aleung/KosselPrinter/RAMPS1.4/README.md

# RAMPS 1.4

官网：<https://reprap.org/wiki/RAMPS_1.4>

## 接线

电源输入

- 两组电源输入，编号分别为5A（12V）和11A（12V2）。用12V供电，过高电压会有问题。
- 其中11A仅仅用于给D8供电，通常用于热床。
- 其他接口均为通过5A接口输入来供电，包括通过二极管D1向Arduino Mega供电（VIN脚）
- 若Arduino希望通过USB独立供电，则需要断开D1
- 5A接口的输入靠二极管D2稳压到12V，因此输入电压不能高于12V太多
- 11A与5A接口内部电路独立。若不接热床，可以仅仅通过5A接电源输入。要使用D8则必须两个都接电源输入
- 实际测试在打印过程中耗电约50W（无热床，打印头200度），折算为5A接口输入电流约4～5A（所以标记为5A）。
- 在reset按钮旁边的3针接口为可选的PSU（例如ATX电源）连接

  - PS_ON pin: 控制电源的开关，若firmware支持，通过GCODE M80/M81控制。必须要靠5V供电

  - VCC pin：连接到Arduino的5V供电（VCC脚）。此脚可以接ATX电源的5V输出，给Arduino供电。当从此pin供电时，需要断开二极管D1。Arduino不允许同时从VCC和VIN供电。

  - 若要使用PS_ON来软件控制电源开关，应该使用5V供电以保持待机状态，因为电源会长期保持这个5V供电，不会因为PS_ON控制而关闭。

  - 5V pin：舵机（servos）的5V供电接口，可以接电源的5V供电，也可以用跳线与VCC针脚短接。当与VCC针脚短接时，就会使用Arduino的5V给舵机供电（Arduino需要接USB供电），而RAMPS无需接电。3D打印机通常用不上舵机接口，因此此针脚可以不接。

热床供电问题

- 11A接口的PTC自恢复保险F1的电压为16V，不能用24V供电
- 热床用12V供电时电流可达10A以上，要求电源至少能供给11A
- 热床供电（D8）的MOSFET非常热
- PCB的设计和制作问题，大电流容易出现过热烧坏
- 建议使用外接 MOSFET relay 模块对热床供电，D8仅作为控制信号
- 外接 MOSFET 热床供电时，必须要串接保险丝，以防短路！！
- 热床通常为100～120W，24V供电时在5A以内，选择8A保险管

D2旁边有个2 pin接口为12V-AUX，可以用于对外提供12V供电，例如RAMPS散热风扇（不可调速）

以下为Marlin固件的预设

D8/9/10输出

- +V端与电源+输入端连通，总有正电压；-V端通过MOSFET连接电源地，受程序控制导通
- 对于某个输出，可以断开+V端（悬空），直接通过独立的电源供电，这样可以选择不同于RAMPS供电电压，例如风扇或者热床采用非12V电压。不同电压的电源需要共地（需要注意电源是否允许这样接）。
- D10: 挤出头1加热
- D9: 挤出头2加热，或者工件散热风扇（调速）
- D8：热床

温度传感器接头

- T0：挤出头1
- T1：热床
- T2：挤出头2
