aleung/KosselPrinter/model/bed_shape/2020/bed_shape.png

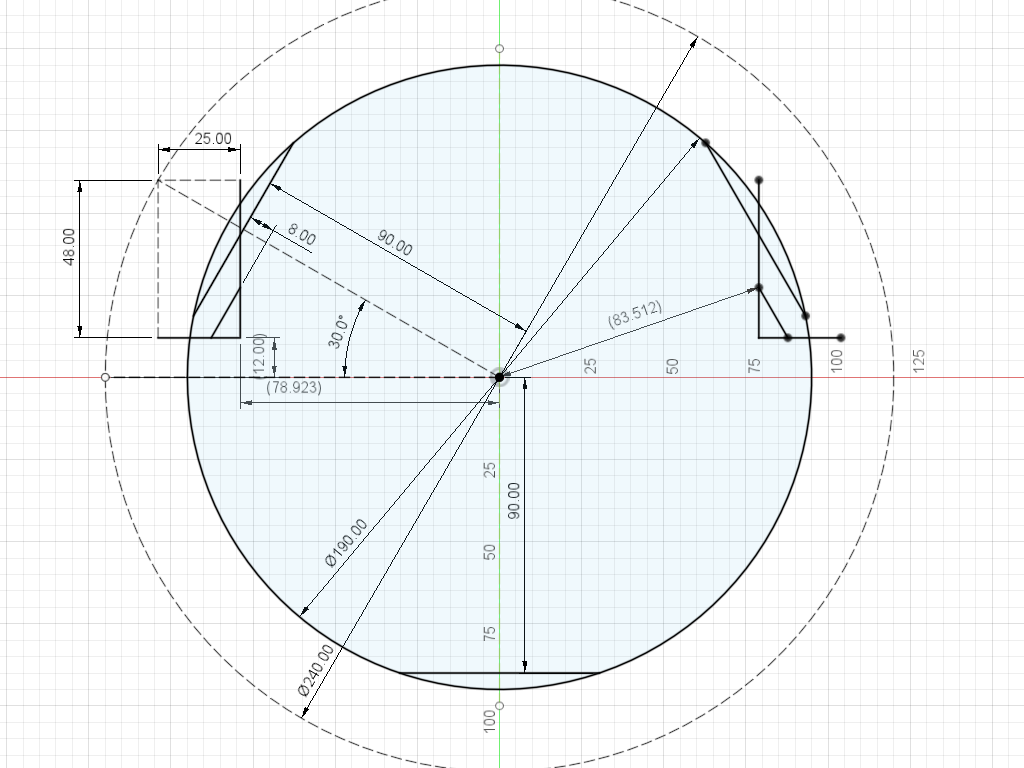
model/bed_shape/2020/bed_shape.png
