aleung/KosselPrinter/model/bed_shape/2020/texture.png

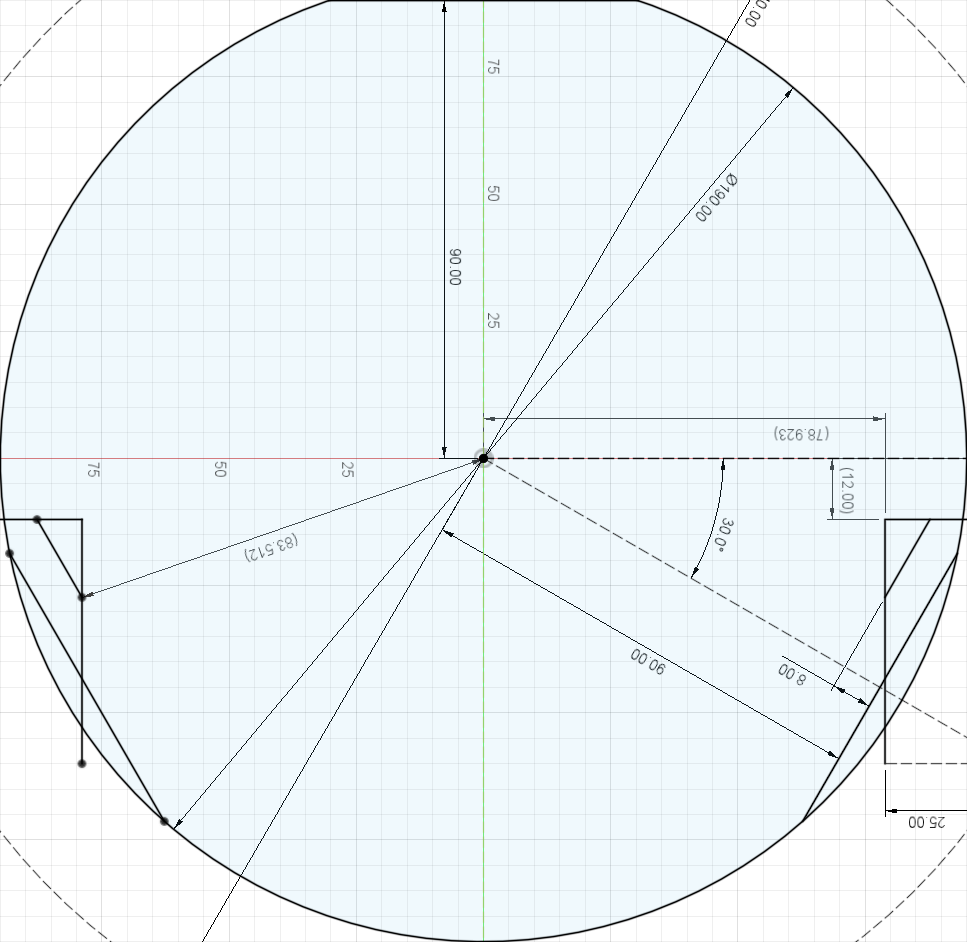
model/bed_shape/2020/texture.png
