aleung/KosselPrinter/model/bed_shape/2021/bed_shape.png

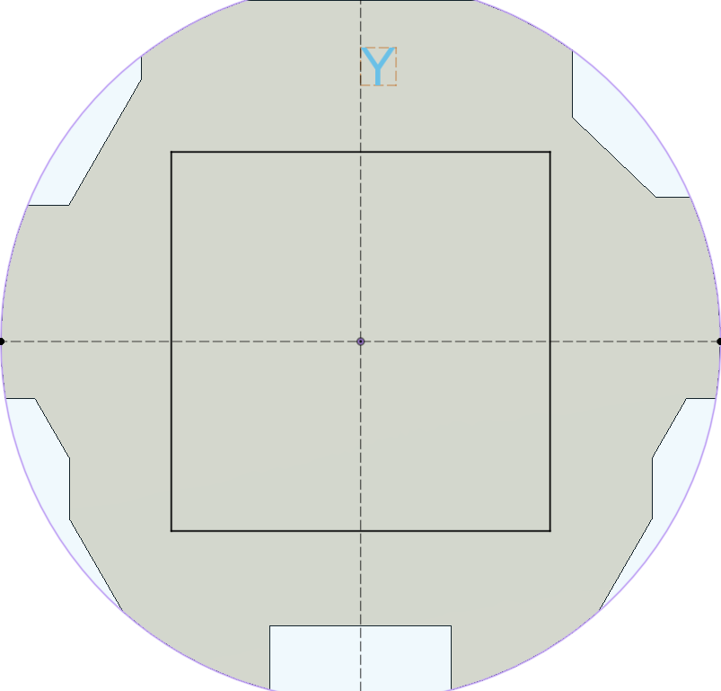
model/bed_shape/2021/bed_shape.png
