aleung/KosselPrinter/RAMPS1.4/RAMPS-connect.jpg

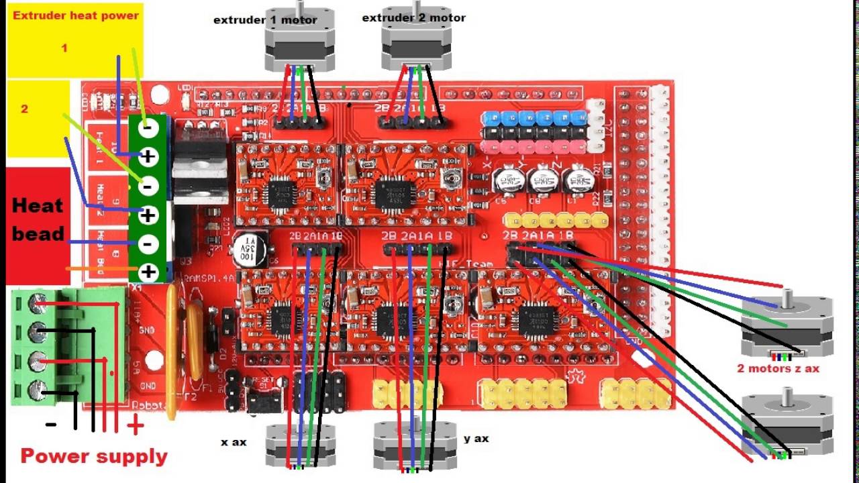
RAMPS1.4/RAMPS-connect.jpg
