aleung/KosselPrinter/RAMPS1.4/real.jpg

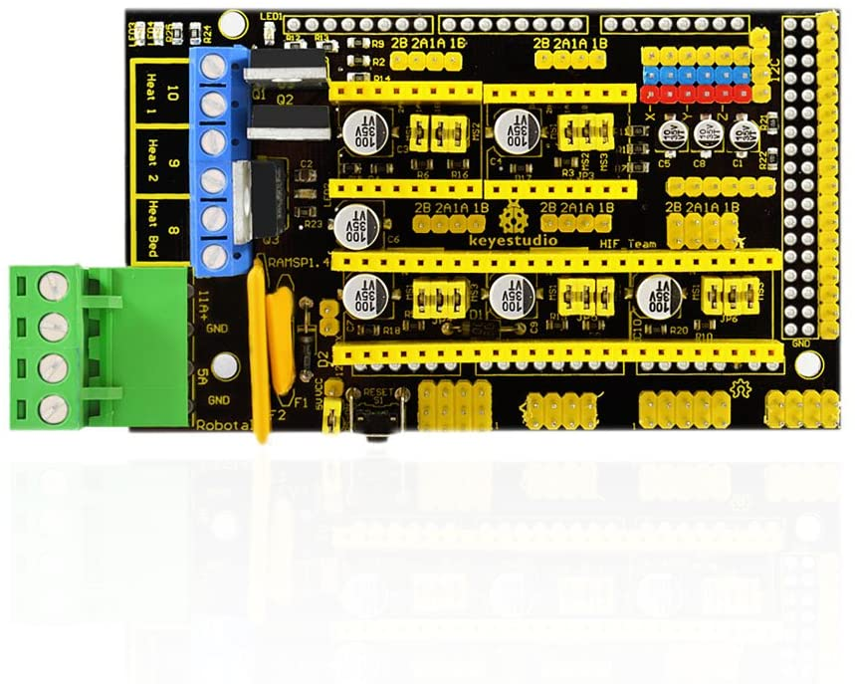
RAMPS1.4/real.jpg
