aleung/KosselPrinter/BOM.xlsx

Item | Type | Quantity | Unit Price | Amount | Taobao ItemID | Seller | Comment | Ordered | Date
框架水平杆 | 240mm, 欧标2020铝材 | 9
框架竖杆 | 650mm, 欧标2020铝材 | 3
 | 共约4米 |  | 12 | 50 | 36456442504 | 广东华通铝业 | 欧标 | received | 2015-10
框架连接件 | 铝 | 1 set |  | 160 | 43119800256 | kossel铝合金件 | 可用欧标铝型材，但竖杆固定只能用国标方螺母 | received | 2015-10
M3欧标 T 型滑块 |  | 50 | 0.23 | 11.5 | 41970628579 | 华达五金店 | 框架，应该用 M4代替 | received | 2015-10
M3欧标 T 型螺母 | 20-TM3 | 100 | 0.45 | 45 | 16474621166 | 广东华通铝业
 |  | 100 | 0.18 | 18 | 41911582347 | 华达五金店 |  | received | 2015-10
M3垫圈 |  | 100 |  | 2.2 | 40089954194 | creaby旗舰店 | 不需要这么多 | received | 2015-10
M3*6mm 内六角螺丝 |  | 50 |  | 2.39 | 40151436582 | creaby旗舰店 | 基本上用不着，都用 M3*8 | received | 2015-10
M3*8mm 内六角螺丝 |  | 100 |  | 4.78 | 40151436582 | creaby旗舰店 | 框架及大部分元件安装，框架应该用 M4代替 | received | 2015-10
M3*10mm 内六角螺丝 |  |  |  |  |  |  | 一部分地方M3*8不够长，需要10
M3*14mm内六角螺丝
M3*20mm内六角螺丝 |  | 6 | 0.09 | 0.54 | 44753078109 | creaby旗舰店 | 滑车 | received | 2015-10
M3*25mm 内六角螺丝 |  | 12 | 0.11 | 1.32 | 44753078109 | creaby旗舰店 | 法兰轴承，效应器挂杆 | received | 2015-10
M3*35mm 内六角螺丝 |  | 6 | 0.15 | 0.9 | 44753078109 | creaby旗舰店 | 皮带张紧 | received | 2015-10
M3尼龙防松自锁螺母 |  | 12 | 0.08 | 0.96 | 40003646337 | creaby旗舰店 |  | received | 2015-10
M2.5*12mm内六角螺丝 |  | 6 | 0.06 | 0.36 | 40150872890 | creaby旗舰店 | 微动开关 | received | 2015-10
M2.5*16mm内六角螺丝 |  | 3 | 0.07 | 0.21 | 40150872890 | creaby旗舰店 | 水平探测 | received | 2015-10
M4*10mm内六角螺丝 |  | 50 |  |  |  |  | 框架 | received | 2015-10
M4国标方螺母 |  | 50 |  |  |  |  | 框架 | received | 2015-10
MGN12H 直线滑轨 | 450mm | 3 | 150 | 450 | 42974167954 | 锐力斯传动总店 | 500mm
 |  | 1 set |  | 648 | 14821319932 | 上海恩瑞特传动科技 | 上银
 |  |  |  | 279 | 13271784463 | 上海顺祥传动轴承 | 国产 500mm
 |  |  |  | 279 | 26759568854 | 上海勤慎机电 | 国产，质量差，退货 | returned
 |  | 1set |  | 407 | 38226154679 | 精嘉 | 仿HIWIN，实际国产 | received | 2015-10
2GT-6 同步带 | 6mm宽，2mm齿距，长1280mm，3根 (共约4m) |  | 6.5/m | 25 | 36528715418 | 小齿距同步带同步带轮 | 要买好点的？
 |  |  | 14.1/m | 56 | 37292680594 | 锐力斯传动总店 | UNITTA | received | 2015-10
GT2同步轮 | 齿宽7mm，齿距2mm，5mm孔径，齿数16齿 | 3 | 7 | 21 | 36316218657 | 小齿距同步带同步带轮
 |  | 3 | 8.5 | 25.5 | 44752555536 | 锐力斯传动总店 | 16-2GT-6-P5 | received | 2015-10
法兰轴承 | F623zz | 6 | 2.5 | 15 | 38330349569 | 瓦通五金专营店
 |  | 6 | 1.5 | 9 | 43459032197 | kossel铝合金件 |  | received | 2015-10
步进电机 | 42步进（NEMA17），机身长度47mm，5mm 直径 D 型轴 , 1.8度 | 3 | 45 | 135 | 3949282634 | 乐清宇辉精密电机 | 42BYGH47-401A, 0.55Nm，1.5A；加装杜邦4pin端子 有一个容易失步，需要更换 | received | 2015-10
 |  | 1 | 32.5 | 32.5 | 42769125555 | 嘉利保点子 | 42BYGH47-1704A, 0.55Nm, 1.7A |  | 2018-1
送料步进电机 | 42步进（NEMA17），机身长度60mm，D 轴 | 1 | 65 | 65 | 4094495224 | 乐清宇辉精密电机 | 42BYGH60-401A, 0.7Nm，1.5A；加装杜邦4pin端子 | received | 2015-10
远程挤出机 | MK8, 铝 | 1 set |  | 45 | 45550954200 | 普林特电子 | 扳机型，已配接头 | received | 2015-10
 | 铝 | 1 set |  | 88 | 521771801250 |  | 马蹄型，无接头、送丝轮？
挤出头 | 0.4mm直径挤出嘴+加热铝块+12V40W加热棒+100k热敏电阻+铝散热片/喉管+直插接头，1.75mm远程挤出 |  |  |  |  |  | PC4-01直插接头
 |  |  |  | 75 | 44518399646 | 人人三维 | E3D v6+2.0,配送0.8米远程送料管
 |  |  |  | 48 | 43794905334 | 人人三维 | E3D v6+
 |  |  |  | 27.7 | 42759070743 | 普林特电子 | E3D v6 | received | 2015-10
喉管 | E3D v6, 1.75mm 内置铁氟龙管 | 2 | 1.07 | 2.14 |  | 启庞3D | 不容易堵头 | received | 2018-1
 | E3D v6, 4.1内孔直通 | 1 | 0.5 | 0.5 |  | 启庞3D |  | received | 2018-1
快接头 | E3D v6 ，直通，M4管径 | 3 | 0.77 | 2.31 |  | 启庞3D |  | received | 2018-1
喷嘴 | E3D v6, 1.75mm耗材，0.4mm | 2 | 0.65 | 1.3 |  | 启庞3D |  | received | 2018-1
打印头风扇 |  | 1 |  | 6.8 | 43279615296 | 普林特电子 | v6风扇罩 | received | 2015-10
微型钻头 | 0.4mm |  |  | 2 | 40274533254 | 普林特电子 | 疏通挤出头 | received | 2015-10
四氟管 | 内径2mm外径4mm，65cm |  | 2.1 |  | 21657103024 |  | 透明
 |  |  | 1.8 |  | 527848098168 | 启庞3D | 乳白色 | received | 2018-1
 |  |  | 3 |  | 43015114835 | 普林特电子 | 透明 | received | 2015-10
斜杆 | 碳管+球头/鱼眼 |  |  |  |  |  |  | NA
 |  |  |  | 70 | 520632284040 | 学生党3DIY创意馆 | M3鱼眼+5*3碳杆，已粘好
 |  |  |  | 75 | 42759507561 | MICROMAKE | M3鱼眼+5*3碳杆，已粘好
斜杆套件 | 斜杆+效应器+斜杆滑车连接件+螺丝 |  |  | 199 | 45475115936 | 人人三维 | 注塑件，鱼眼 | received | 2015-10
 |  |  |  | 160 | 43800881158 | 子浩科技 | PLA打印机，M3鱼眼，3010散热风扇+5012鼓风
效应器 | 铝
同步带张紧弹簧 |  | 3 | 0.09 | 0.27 |  | 启庞3D |  | received | 2018-1
斜杆减震弹簧 |  | 3 | 0.19 | 0.57 |  | 启庞3D |  | received | 2018-1
底盘 | 高硼硅玻璃，直径200mm，厚3mm |  | 1 | 25 | 39147972804 | 秦皇岛利东特种玻璃
 |  |  |  | 28 | 44631332459 | 人人三维
 |  |  |  | 20 | 521224739716 | 普林特电子 |  | received | 2015-10
热床电源 | 24V |  |  | 35 |  |  | 明纬 NES-350-24 |  | 2021-1
热床MOS模块 |  |  |  | 8.99 |  |  |  |  | 2021-1
热床 |  |  |  | 30 |  |  | 直径220，厚度3mm，铝基板，PCB |  | 2021-1
非标件套装 | 滑块推杆座+效应器+限位开关底座+挤出机+自动调平感应座 |  |  | 50 | 45052661238 | 学生党3DIY创意馆 | 打印件 | NA
压力传感器 | 调平用，套在喷嘴上 |  |  | 19.8 | 547224018549 | 小柴人3D | 配 E3D v6 喷嘴 | received | 2018-1
光电限位开关 |  | 4 | 3.9 | 15.6 | 550314940030 | 小柴人3D | 只需3个 | received | 2018-1
微动开关 | 欧姆龙SS-5 | 4 | 1.91 | 7.64 | 8984572298 | 上海仁玺电子 | 印尼产 SS-5GL
 |  | 4 | 1.9 | 7.6 | 36299264965 | 品牌继电器 | 印尼产 SS-5GL
 |  | 4 | 3 | 12 | 45755819186 | 人人三维 | 印尼产 SS-5GL | received | 2015-10
限位开关底座 |  | 3 | 2 | 6 | 524303187130 | 劲云三维 |  | received | 2017-12
Power | 12V >5A |  |  | 29 | 45859425007 | 腾锋线材 | 台达，10A | received | 2015-10
Arduino | MEGA2560 R3 | 1 | ~40 |  |  |  |  | NA
LCD模块 | Reprap2004 | 1 |  | 28 | 38267240503 |  |  | NA
RAMPS1.4 |  | 1 | 20~27 | 25 | 522117368072 | 人人三维 |  | NA
步进电机驱动 | 2A电流的绿色4988驱动 | 4 | 6.7 | 26.8 | 37933530722 |  | 附送散热片及双面硅胶 | NA
 | TMC2225 | 3 | 11.07 | 33.21 |  | 启庞3D |  |  | 2022-6
 | 乐积TMC2225 | 1 | 12.8 | 12.8 |  | 乐积科技 |  |  | 2023-2
控制电路套件 |  | 1 set
 |  |  |  | 130 | 40241939700 | 普林特电子 | MEGA2560+RAMPS+2004LCD+4988*5+散热片 REPRAP_DISCOUNT_SMART_CONTROLLER | received | 2015-10
 |  |  |  | 102 | 40273837410 | 普林特电子 | MEGA2560+RAMPS+4988*5+散热片
电路板散热风扇 |  | 1 |  |  |  |  |  | received | 2015-10
打印耗材 | 1.75mm 直径，PLA, 1kg | 2 | 66 | 132 | 19695022005 | Kexcelled 3D打印耗材 |  | received | 2015-10
 | 1.75mm 直径，PLA, 500g | 1 | 25 | 25 | 556517045680 | 启庞3D | 白色 | received | 2018-1
游标卡尺 |  |  |  | 93 |  | 华诚五金 | 广陆150mm，0.02mm | received | 2015-10
PVP固体胶 |  |  |  |  |  |  | PVP材质固体胶可以代替美纹纸，牌子不限 | received
螺纹胶 | 242型，颜色蓝色，温度范围-50~150℃，固化时间20min/24h(初固/全固)
扎带 | 3*80mm, 1000条 |  |  | 10 | 18876170071 | 腾锋线材 | 有些地方长度不够 | received | 2015-10
扎带 | 12cm
润滑黄油
电线缠绕管 | 8mm，10m |  |  | 6 |  | 普林特电子 |  | received | 2015-10
热缩管 | 1, 2, 4mm 各半米 |  |  | 2 | 43199296385 | 人人三维 | 1mm太细，没有用 | received | 2015-10
杜邦线 | 70cm 2pin 母－母 | 5 | 0.6 | 3 | 37169898528 | 普林特电子 |  | received | 2015-10
导热胶
铲子
密封盒 | 8.5L，KL－2020，27*20*23cm |  |  | 24.3 | 3095680751 | 莎莎日用生活馆 | 装耗材 | received | 2018-1
变色硅胶干燥剂（橙色） | 500g |  |  | 15.8 | 39042466599 | 禾壹诚品 | 耗材吸湿 | received | 2018-1
