aleung/KosselPrinter/parts/effector.jpg

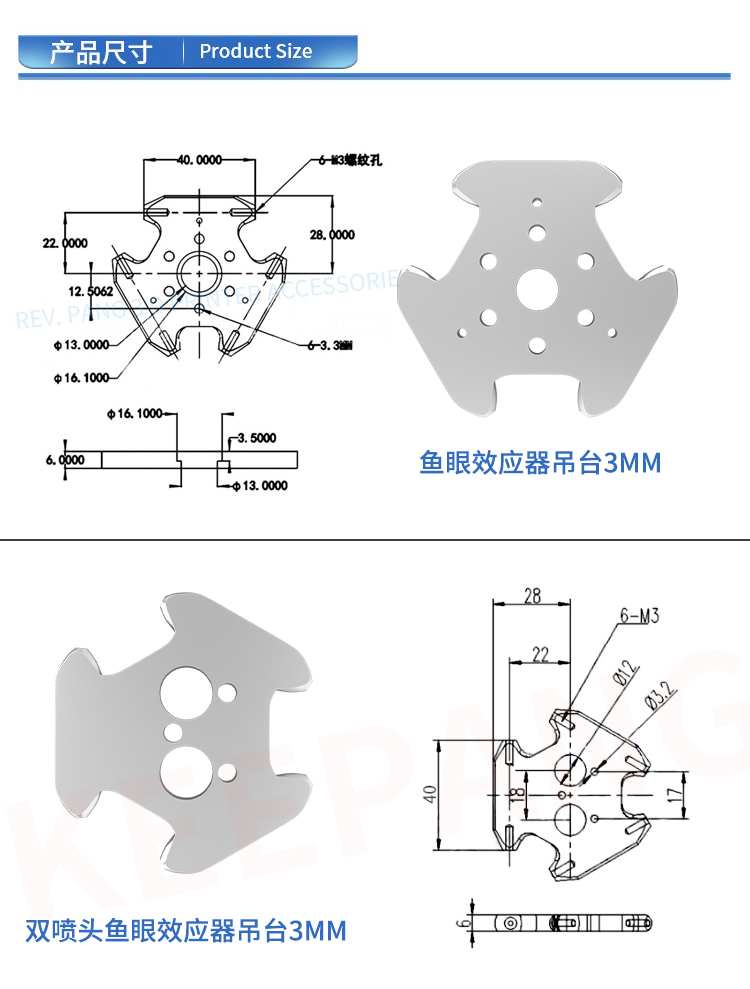
parts/effector.jpg
