aleung/KosselPrinter/parts/heat-bed.png

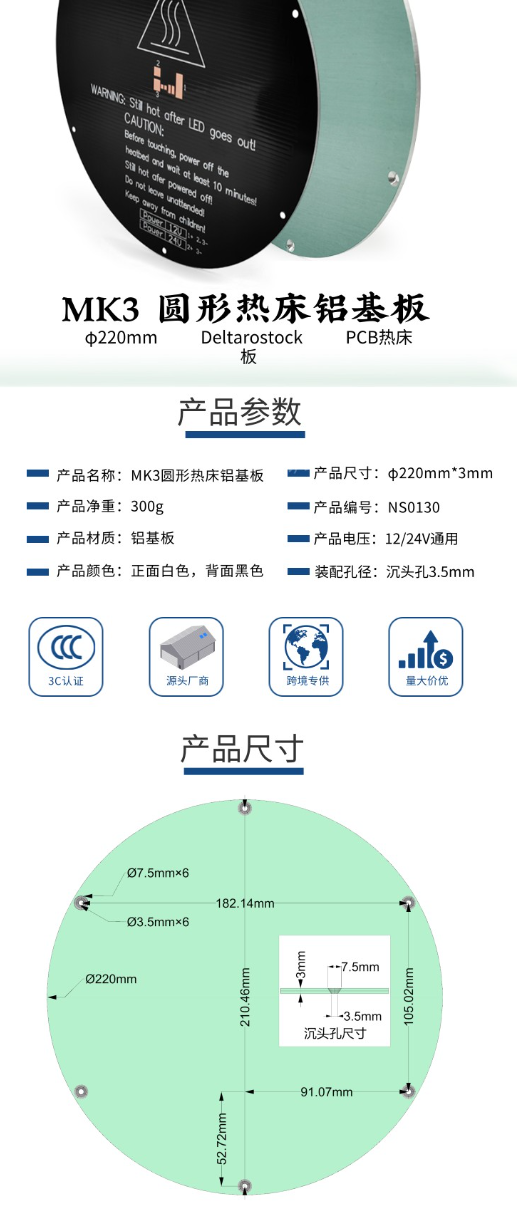
parts/heat-bed.png
