aleung/KosselPrinter/parts/hotbed-power-control.png

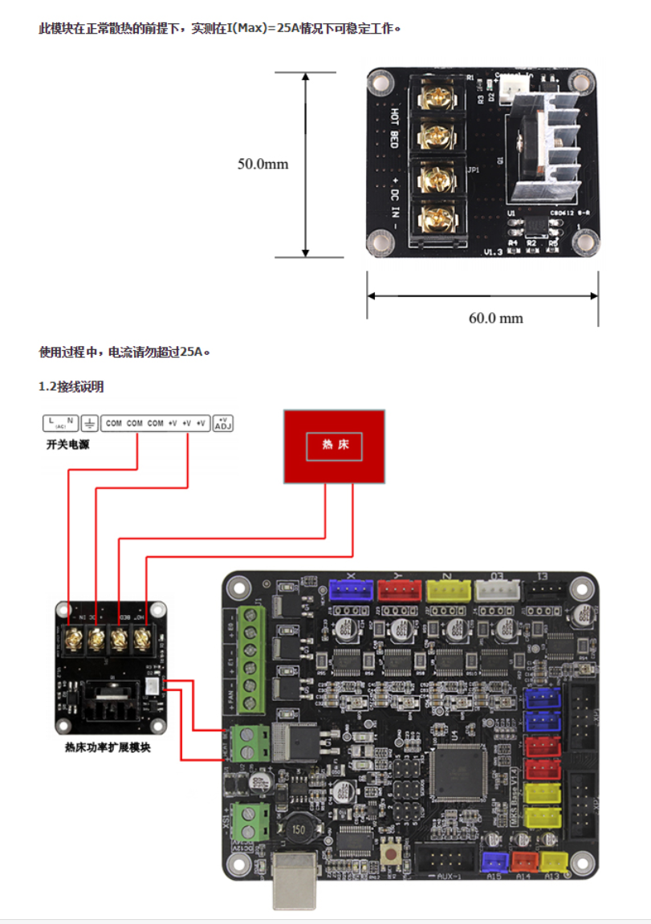
parts/hotbed-power-control.png
