aleung/KosselPrinter/parts/TMC2225-1.png

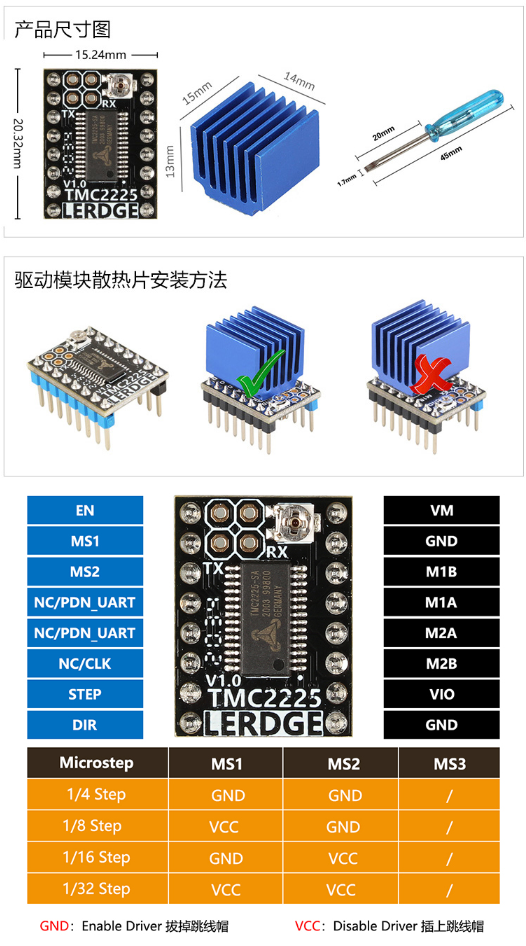
parts/TMC2225-1.png
