aleung/KosselPrinter/parts/TMC2225-2.png

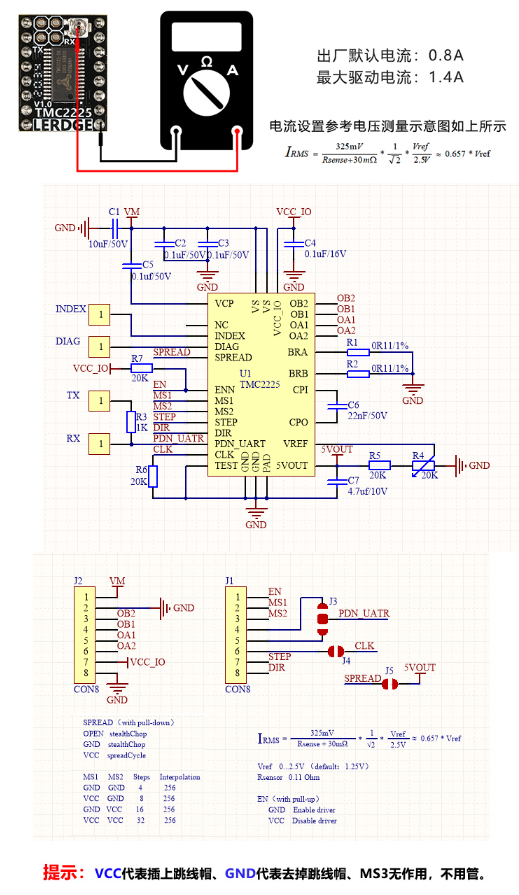
parts/TMC2225-2.png
