aleung/KosselPrinter/model/bed_shape/2020/bed_shape.stl

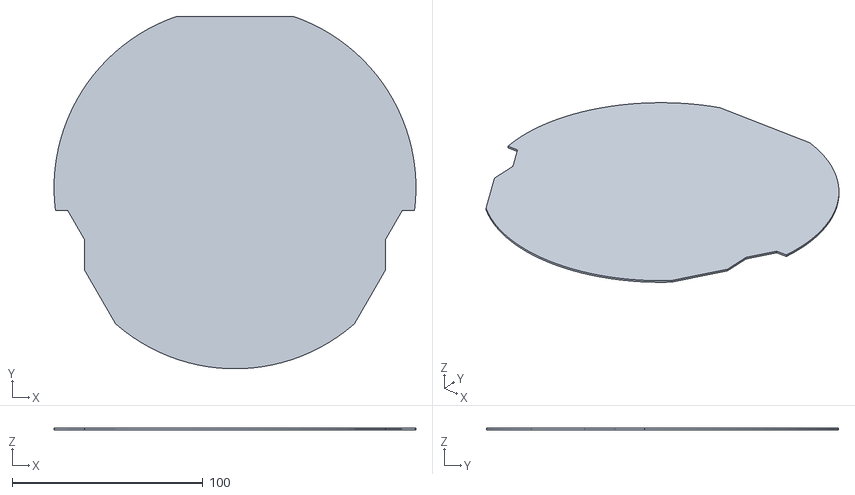
[picture p14: CAD file, 2020-04-05]
model/bed_shape/2020/bed_shape.stl
190.0 x 185.0 x 1.00
