aleung/KosselPrinter/model/calibration/klipper_delta_calibrate_size.3mf

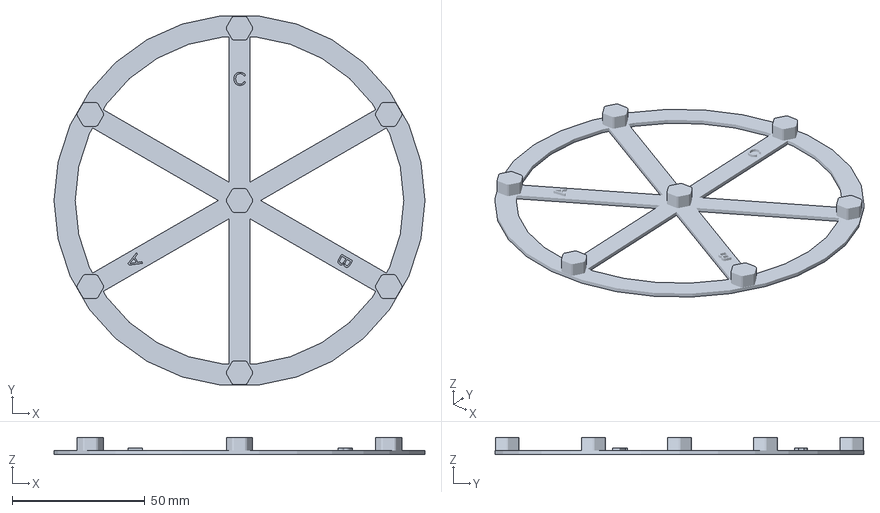
[picture p15: CAD file, 2023-03-03]
model/calibration/klipper_delta_calibrate_size.3mf
140.0 x 139.2 x 6.50 mm
