aleung/KosselPrinter/model/calibration/ExtrusionMultiplier.3mf

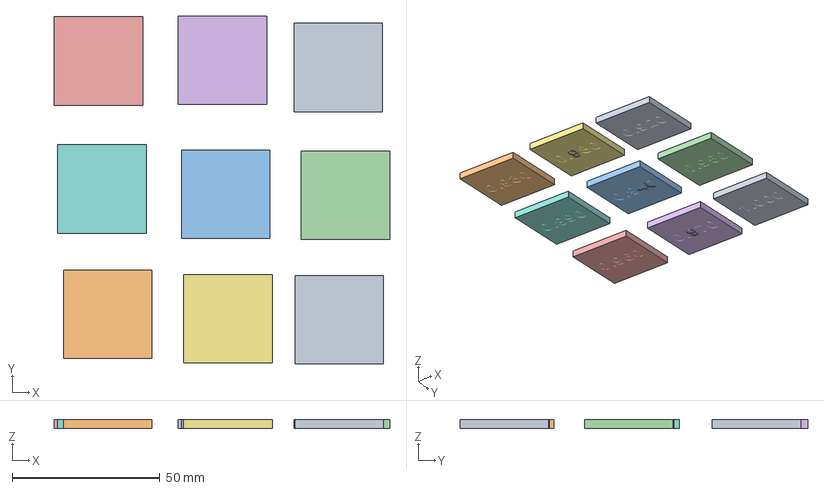
[picture p16: CAD file, 2023-02-26]
model/calibration/ExtrusionMultiplier.3mf
113.5 x 117.6 x 3.00 mm
EM_Cube-0.920.stl
EM_Cube-0.930.stl
EM_Cube-0.940.stl
EM_Cube-0.950.stl
EM_Cube-0.960.stl
EM_Cube-0.970.stl
EM_Cube-0.980.stl
EM_Cube-0.990.stl
EM_Cube-1.000.stl
