aleung/KosselPrinter/model/calibration/simple-crossing.stl

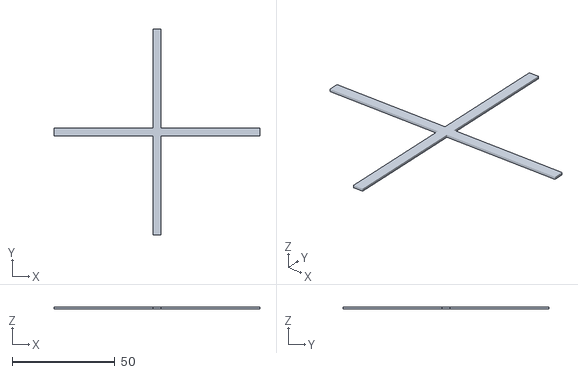
[picture p17: CAD file, 2021-02-12]
model/calibration/simple-crossing.stl
100.0 x 100.0 x 1.00
