aleung/KosselPrinter/model/calibration/xy100mm.stl

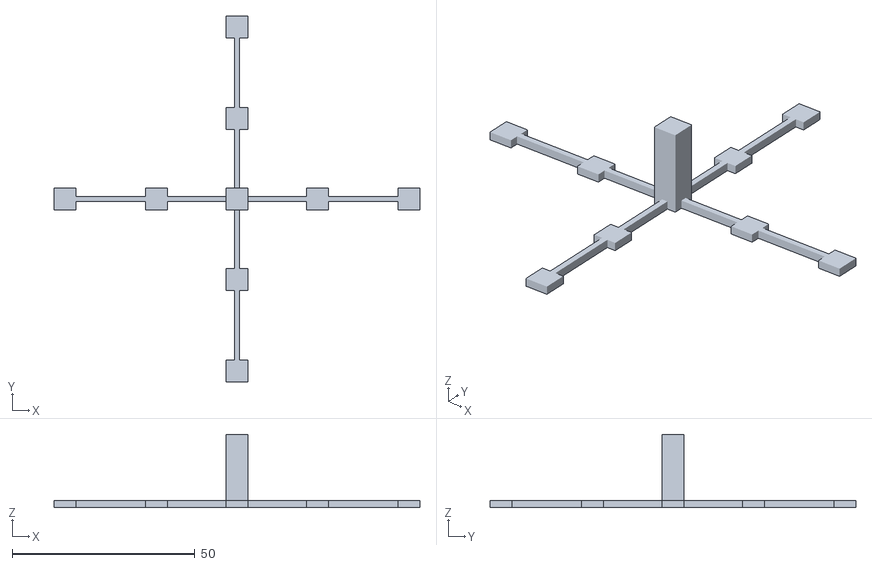
[picture p18: CAD file, 2021-02-12]
model/calibration/xy100mm.stl
100.0 x 100.0 x 20.0
