aleung/KosselPrinter/model/calibration/Overhang_Angle_Test_55-85.stl

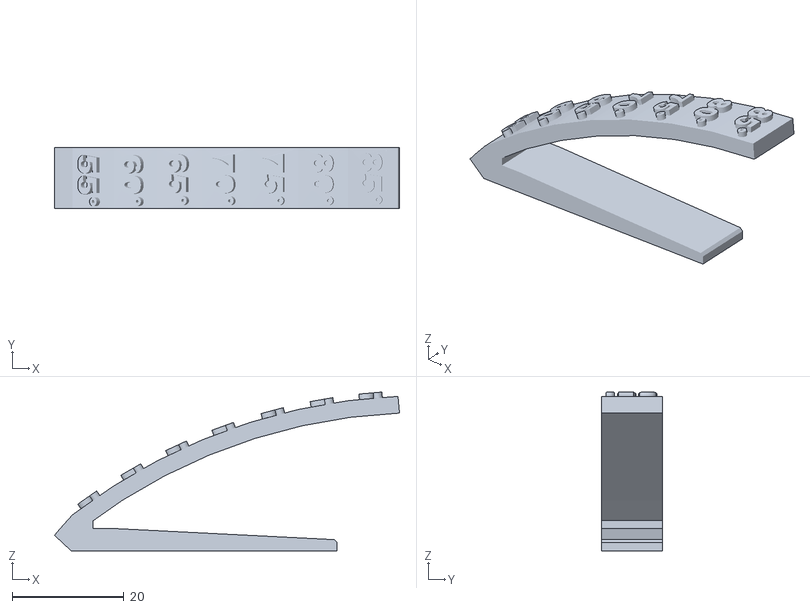
[picture p19: CAD file, 2020-03-05]
model/calibration/Overhang_Angle_Test_55-85.stl
61.8 x 11.0 x 28.4
