aleung/KosselPrinter/model/calibration/bridge.stl

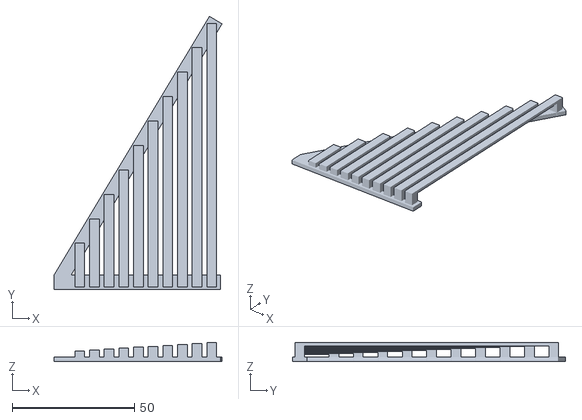
[picture p20: CAD file, 2020-03-05]
model/calibration/bridge.stl
68.8 x 111.8 x 7.90
