aleung/KosselPrinter/model/calibration/xyzCalibration_cube.stl

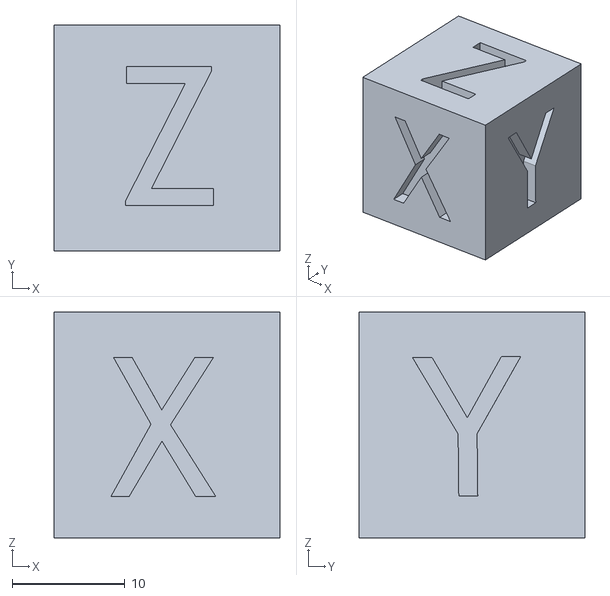
[picture p21: CAD file, 2018-02-03]
model/calibration/xyzCalibration_cube.stl
20.0 x 20.0 x 20.0
