aleung/KosselPrinter/(list of files, cad)

Other CAD files:
model/bed_shape/2021/bed_shape.stl
making/plumb_bob/polyScrewThread_r1.scad
model/bed_shape/2020/bed_shape.f3d
model/bed_shape/2021/bed_shape.f3d
model/calibration/klipper_delta_calibrate_size.stl
model/calibration/xy100mm.f3d
