aleung/KosselPrinter/(commit log)

2015-09-28 所有元件基本上已经选定买齐
    [BOM.xlsx]
2015-10-13 滑轨下单
    [BOM.xlsx]
2016-02-28 全部零件齐备
    [BOM.xlsx]
2017-12-25 加电测试完成，补充资料
    [BOM.xlsx]
2018-02-03 Add models
    [BOM.xlsx, e3d_v6_2in1_duct.scad, e3d_v6_2in1_duct.stl, endstop.scad, light-blocker.scad, xyzCalibration_cube.stl]
2018-02-03 Update E3D 2in1 duct after first print
    [e3d_v6_2in1_duct.scad, e3d_v6_2in1_duct.stl]
2018-02-05 Change fan tilt to 30 degree
    [e3d_v6_2in1_duct.scad, e3d_v6_2in1_duct.stl]
2018-02-06 Minor adjustment after printout, fix too thin hotted duct
    [e3d_v6_2in1_duct.scad, e3d_v6_2in1_duct.stl]
2018-02-22 Finish LCD Box design
    [lcd_box.scad, lcd_box_bottom.stl, lcd_box_support.stl, lcd_box_top.stl, pinwheel_stand.scad]
2018-02-25 整理模型文件
    [e3d_v6_2in1_duct.scad, e3d_v6_2in1_duct.stl, endstop.scad, lcd_box.scad, lcd_box_bottom.stl, lcd_box_support.stl, lcd_box_top.stl, light-blocker.scad]
2018-03-10 Add new models
    [output.stl]
2018-03-21 Add new model
    [main.stl]
2018-06-03 Add makings
    [customizable_U_hook.scad, customizable_sanding_stick.scad, index.stl, pinwheel_stand.scad, polyScrewThread_r1.scad]
2018-07-14 making: bike rear light mount
    [back.stl, bike-rear-light-mount.scad, front.stl]
2018-07-22 Add making: torch diffuser, bike beam cutoff
    [beam-cutoff.scad, beam-cutoff.stl, torch_diffuser.scad, torch_diffuser.stl]
2018-07-25 将反光板做成弧形，扩大光斑范围
    [beam-cutoff.scad]
2018-07-25 基于v2的平面反光板版本作为v3基础
    [beam-cutoff.scad]
2018-07-25 平面反射面上增加棱柱，扩大反光范围
    [beam-cutoff.scad]
2018-07-25 改反光面为部分圆柱
    [beam-cutoff.scad, beam-cutoff.stl]
2018-07-27 减少反光板倾角，照亮更远处
    [beam-cutoff.scad]
2018-09-11 New modules
    [body.scad, configure.scad, index.scad, rotor.scad, tab.scad]
2018-09-12 update path to relativity.scad library
    [body.scad, index.scad, rotor.scad, tab.scad]
2018-09-16 soap holder
    [index.scad, index.stl]
2019-01-04 Filament hanger
    [assembled.scad, parts.scad]
2019-01-06 Final make of 喇叭转接环
    [index.scad, index.stl]
2019-01-07 Bottle coupler
    [PETcap.scad, bottle-coupler.stl, coupler.scad]
2019-01-16 牙膏牙刷挂架
    [toothbrush-holder.scad, toothbrush-holder.stl, toothpaste-wall-holder.scad, toothpaste-wall-holder.stl]
2019-01-21 Display controller board cover
    [index.scad, index.stl]
2019-01-21 New making
    [cap-holder.scad, cap-holder.stl, index.scad, index.stl, toothbrush-holder.scad, toothbrush-holder.stl]
2019-02-05 完成牙膏牙刷挂架
    [cap-holder.scad, cap-holder.stl, cup-holder.scad, cup-holder.stl, toothpaste-wall-holder.scad, toothpaste-wall-holder.stl]
2019-02-05 滑车挡板
    [index.scad]
2019-02-06 add STL files
    [pinwheel_stand.scad, pinwheel_stand_39x2.stl, pinwheel_stand_39x3.stl]
2019-02-12 Fix IKEA JÄLL laundry bag belt breakage
    [index.scad, index.stl]
2019-02-14 延长横杆，长于丝卷宽度
    [parts.scad]
2019-02-14 large version soap holder
    [large.scad, large.stl]
2019-02-27 角阀水管盖子
    [index.scad, index.stl]
2019-02-27 Update glass bed clamp v2
    [v1.stl, v2.scad, v2.stl]
2019-03-04 Hole cover
    [index.scad, index.stl]
2019-03-06 角阀墙孔盖
    [ring.scad, ring_d24.stl]
2019-03-10 rope cleat
    [index.scad, normal-body.stl, normal-covers.stl, small-body.stl, small-covers.stl]
2019-03-15 RAMPS case v2
    [v2-bottom.stl, v2-top.stl, v2.scad]
2019-03-23 牙刷头挂架加卡沿
    [toothbrush-holder.scad, toothbrush-holder.stl]
2019-04-12 Add and update things
    [assembled.scad, bar_bearing.stl, bracket.stl, index.scad, index.stl, led-power-box.scad, parts.scad, plate-only.scad]
2019-04-13 Update designs
    [bracket-v2.scad, bracket.scad, led-power-box.scad, nut.stl, power-box-plate-only.scad]
2019-05-11 New models
    [2.scad, part1.scad, part2.scad, part2.stl]
2019-05-31 提高紧固度
    [v2.scad]
2019-07-14 MBP 散热底座
    [down.scad, down.stl, upleft.stl, upmid.scad, upmid.stl, upright.scad, upright.stl]
2019-11-23 New makings
    [A.stl, B.stl, a.stl, b.stl, bar.stl, c.stl, cover.scad, cover.stl]
2019-12-15 Update filament holder design
    [assembled.scad, bar.stl, horizontal_bar.scad, parts.scad, topfix.stl, uphold.stl]
2019-12-19 New and update
    [body.stl, clip.stl, cover.stl, index.scad, index.stl, standard.scad, standard.stl]
2019-12-22 minor update
    [index.scad, index.stl]
2019-12-22 支持更宽的丝盘
    [bar_bearing.stl, parts.scad]
2020-01-06 Printer and slicer configuration backup
2020-01-11 E3d v6 风扇座 v2020.01
    [2018_02.scad, 2020_01.scad, 2020_01.stl]
2020-01-17 bed shape for setting in slicer
    [bed_shape.stl, index.scad]
2020-01-25 迪卡侬风车座v2
    [v1.scad, v2.f3d, v2.stl]
2020-02-04 New designs
    [adapter.stl, bottom.stl, component1.stl, design.f3d, gasket.stl, guide.3mf, guide.stl, top.stl]
2020-02-14 New and update models
    [72mm-OnePlus3.f3d, design.f3d, mobile_mount.stl, round.stl, 台灯臂连接件.f3d, 台灯臂连接件.scad]
2020-02-14 Calibration printing
    [Retraction.stl]
2020-02-16 Update design
    [toothbrush-holder-v2.stl, toothbrush-holder.scad]
2020-02-18 Fix: with small diameters (eg 4 mm), the sawdust channel in the drill guide is not properly created.
    [drillguide.scad]
2020-02-18 Support fluid ounce unit
    [conical_measure.scad]
2020-02-20 new design
    [wire-sleeve-d6x20.stl, wire-sleeve.scad]
2020-03-05 New and updated models
    [2018_02.scad, 2020_01.scad, 2020_01.stl, 2020_02_a.f3d, 2020_02_a.stl, 2020_02_b.f3d, 2020_02_b.stl, 2020_02_b2-gasket.stl]
2020-03-05 Printer calibration models
    [20x20x10-cube.stl, Overhang_Angle_Test_55-85.stl, bridge.stl]
2020-03-29 Move 3d models to new repo 3d-model
    [12cm_v1_1.stl, 12cm_v2.stl, 2.scad, 2018_02.scad, 2020_01.scad, 2020_01.stl, 2020_02_a.f3d, 2020_02_a.stl]
2020-04-05 New and calibrated bed shape
    [bed_shape.f3d, bed_shape.stl, index.scad]
2020-04-05 Update calibration setting
2020-05-05 Titan extruder
2021-02-12 Upgrade for PETG: heated bed, fan
    [Calibration.STL, Calibration_Calculus.xlsx, caldeltaV2.stl, simple-crossing.stl, xy100mm.f3d, xy100mm.stl]
2022-08-03 Update bed shape
    [bed_shape.f3d, bed_shape.stl]
2023-02-09 Initial klipper config
    [fluidd.cfg, printer.cfg]
2023-02-19 Update klipper settings
    [gcode_macro.cfg, printer.cfg]
2023-02-19 basic calibration
    [printer.cfg]
2023-02-20 enhanced delta calibration
    [printer.cfg]
2023-02-26 fine tune klipper config
    [ExtrusionMultiplier.3mf, buildin_display.cfg, buildin_menu.cfg, gcode_macro.cfg, lcd_menu.cfg, printer.cfg, test_speed_delta.cfg]
2023-02-26 New slicer config to work with klipper
2023-02-27 Fine tune
    [gcode_macro.cfg, lcd_menu.cfg, printer.cfg]
2023-03-03 Re-calibrate after endstop remount
    [printer.cfg]
2023-03-03 Remove outdated files
    [20x20x10-cube.stl, Calibration.STL, Calibration_Calculus.xlsx, Overhang_Angle_Test_55-85.stl, Retraction.stl, bridge.stl, caldeltaV2.stl, klipper_delta_calibrate_size.3mf]
2023-06-15 Heat bed
2023-07-02 Update HardwareSetup.md, Klipper config and OcraSlicer config
    [gcode_macro.cfg, printer.cfg]
2023-08-12 New hot end
    [printer.cfg]
